grob6000/NixieQuadClock/board/nixiequadclock_pcb_complete.SLDPRT

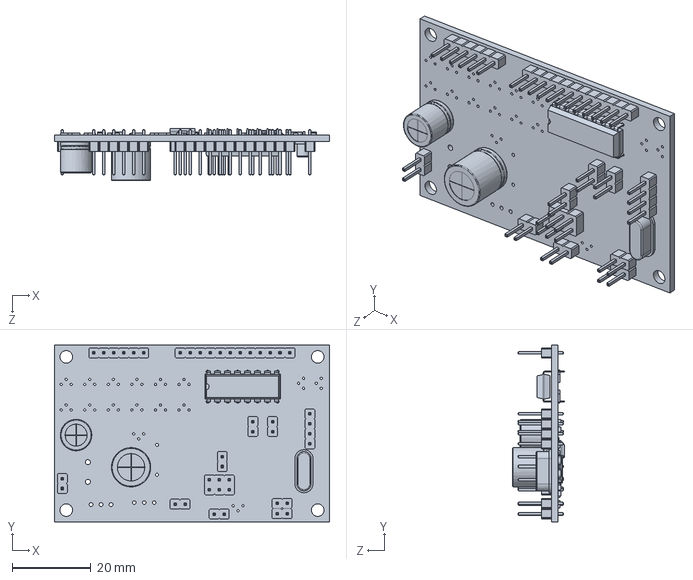
[picture p1: CAD file, 2021-04-23]
board/nixiequadclock_pcb_complete.SLDPRT
70.0 x 45.0 x 13.3 mm
