grob6000/NixieQuadClock/model/nixiequadclock2.SLDASM

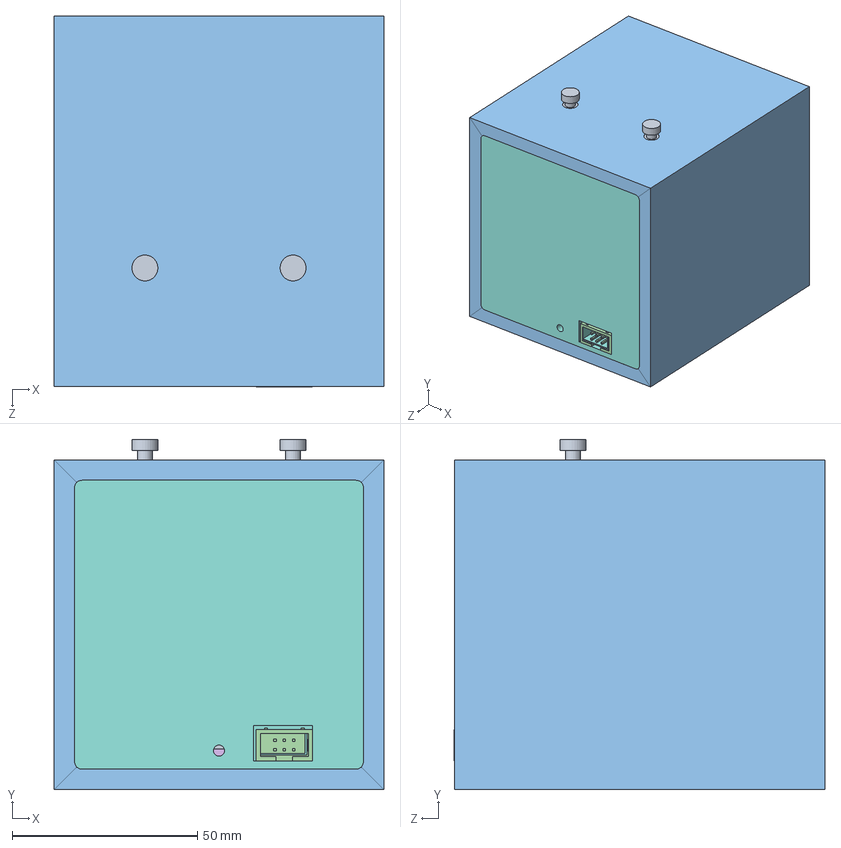
[picture p2: CAD file, 2021-04-23]
model/nixiequadclock2.SLDASM
89.0 x 94.5 x 100.1 mm
nixieblock3
nixie_socket_ukrainian x 4
woodside x 4
in12b x 4
window
gluebracket
circuitboard
plasticback
switch_mini x 2
skm53
skm53_holder
socket_iec6
