grob6000/NixieQuadClock/model/nixiequadclock.SLDASM

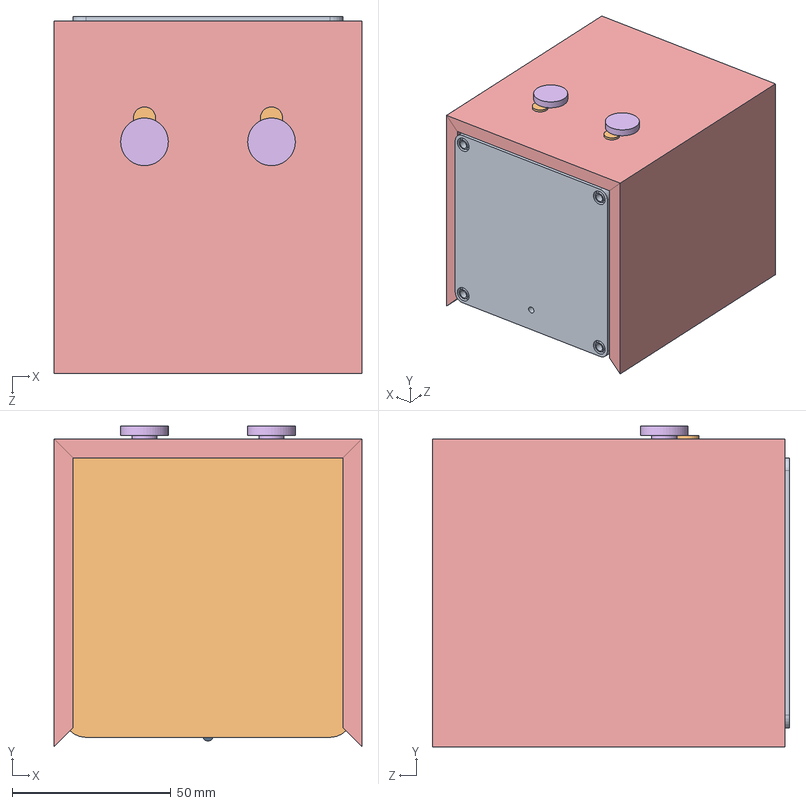
[picture p3: CAD file, 2015-05-10]
model/nixiequadclock.SLDASM
97.0 x 101.0 x 112.5 mm
in12b x 4
window
circuitboard
skm53
woodside x 2
button x 2
nixie_socket_ukrainian x 4
nixieblock_frontblock
nixieblock_rearbox
switch_mini x 2
bolt x 2
nixieblock_wrap
