grob6000/NixieQuadClock/model/woodbox.SLDASM

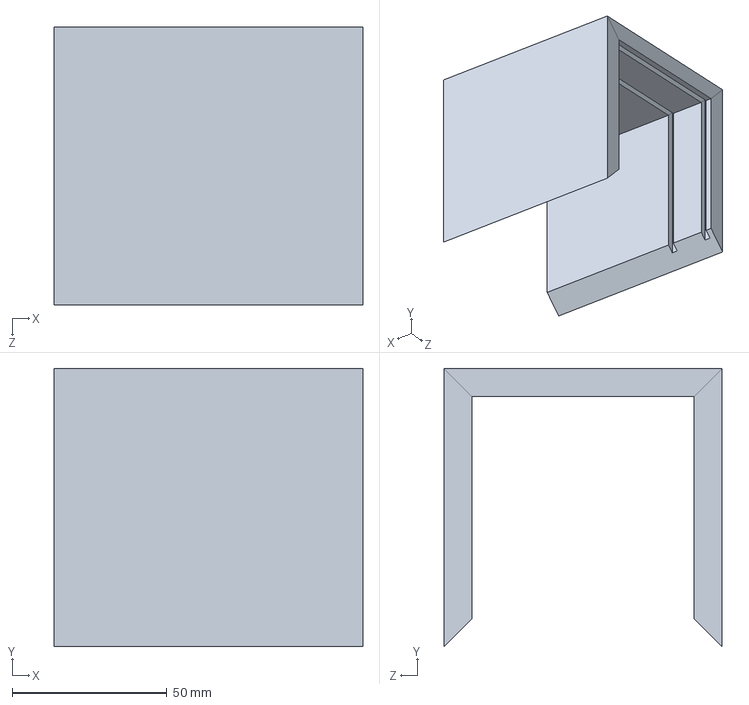
[picture p4: CAD file, 2015-03-24]
model/woodbox.SLDASM
100.0 x 90.0 x 90.0 mm
woodside x 3
