grob6000/NixieQuadClock/model/bell_ebay.step

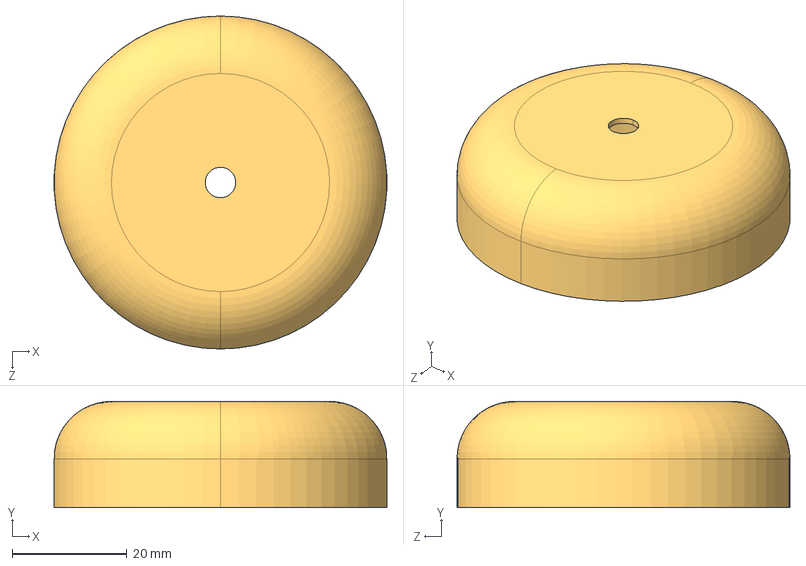
[picture p5: CAD file, 2021-04-23]
model/bell_ebay.step
57.9 x 18.5 x 58.0 mm
