grob6000/NixieQuadClock/board/nixieclockboard.FCStd

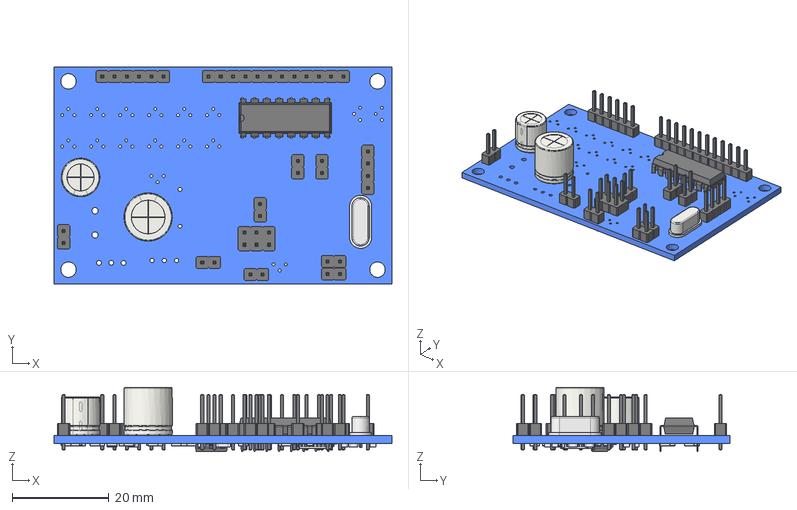
[picture p6: CAD file, 2021-04-23]
board/nixieclockboard.FCStd
70.0 x 45.0 x 13.3 mm
Pcb
C_0805_
C_0805_001
C_0805_002
C_1206_
C_1206_001
C_0805_003
C_0805_004
CP_Radial_D80mm_P380mm_
CP_Radial_D100mm_P500mm_
C_0805_005
C_0805_006
TQFP-32_7x7mm_Pitch0.8mm_
Pin_Header_Straight_1x02_Pitch254mm_
Pin_Header_Straight_1x02_Pitch254mm_001
Pin_Header_Straight_1x02_Pitch254mm_002
Pin_Header_Straight_1x04_Pitch254mm_
Pin_Header_Straight_1x02_Pitch254mm_003
Pin_Header_Straight_1x02_Pitch254mm_004
Pin_Header_Straight_1x12_Pitch254mm_
Pin_Header_Straight_1x06_Pitch254mm_
Pin_Header_Straight_1x02_Pitch254mm_005
Pin_Header_Straight_1x02_Pitch254mm_006
Pin_Header_Straight_1x02_Pitch254mm_007
R_0805_
R_0805_001
R_0805_002
R_0805_003
R_0805_004
R_0805_005
R_0805_006
R_0805_007
R_0805_008
R_0805_009
R_0805_010
R_0805_011
R_0805_012
R_0805_013
R_0805_014
R_0805_015
R_0805_016
R_0805_017
R_0805_018
R_0805_019
R_0805_020
R_0805_021
R_0805_022
R_0805_023
R_0805_024
R_0805_025
R_0805_026
R_0805_027
R_0805_028
R_0805_029
R_0805_030
R_0805_031
R_0805_032
R_0805_033
R_0805_034
R_0805_035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
