grob6000/NixieQuadClock/model/in12b.step

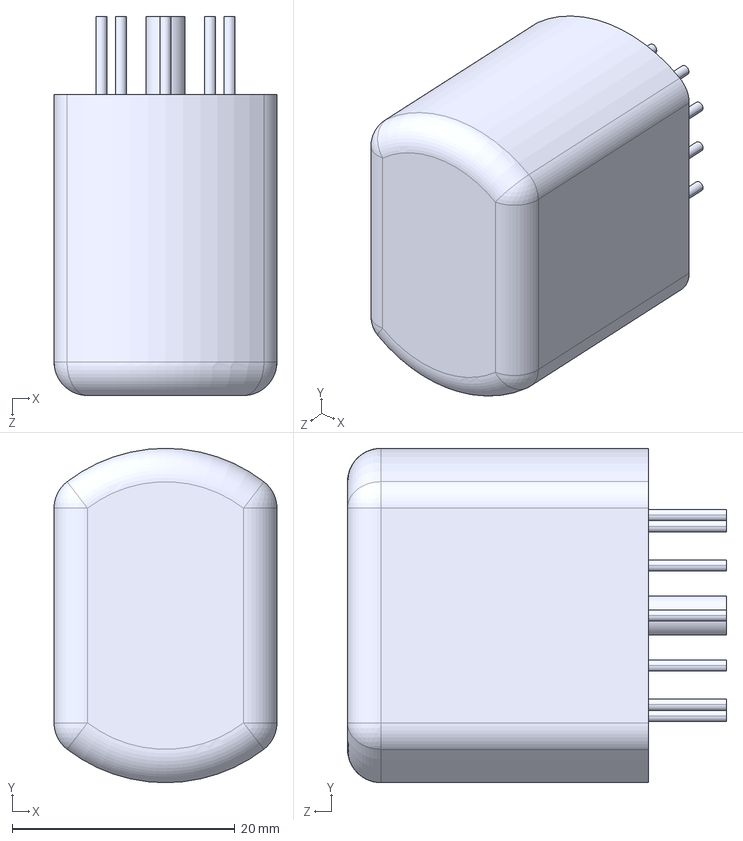
[picture p7: CAD file, 2021-04-23]
model/in12b.step
20.0 x 30.0 x 34.0 mm
