grob6000/NixieQuadClock/model/nixieblock_rearbox.step

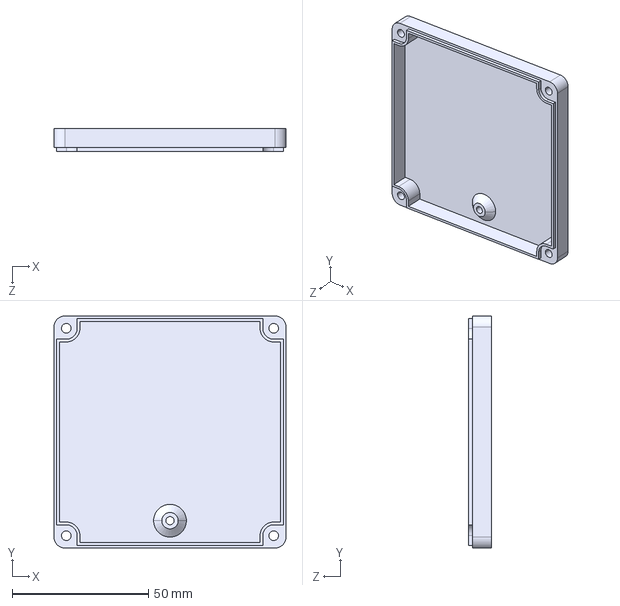
[picture p8: CAD file, 2021-04-23]
model/nixieblock_rearbox.step
85.0 x 85.0 x 8.50 mm
