grob6000/NixieQuadClock/model/nixieblock_frontblock.step

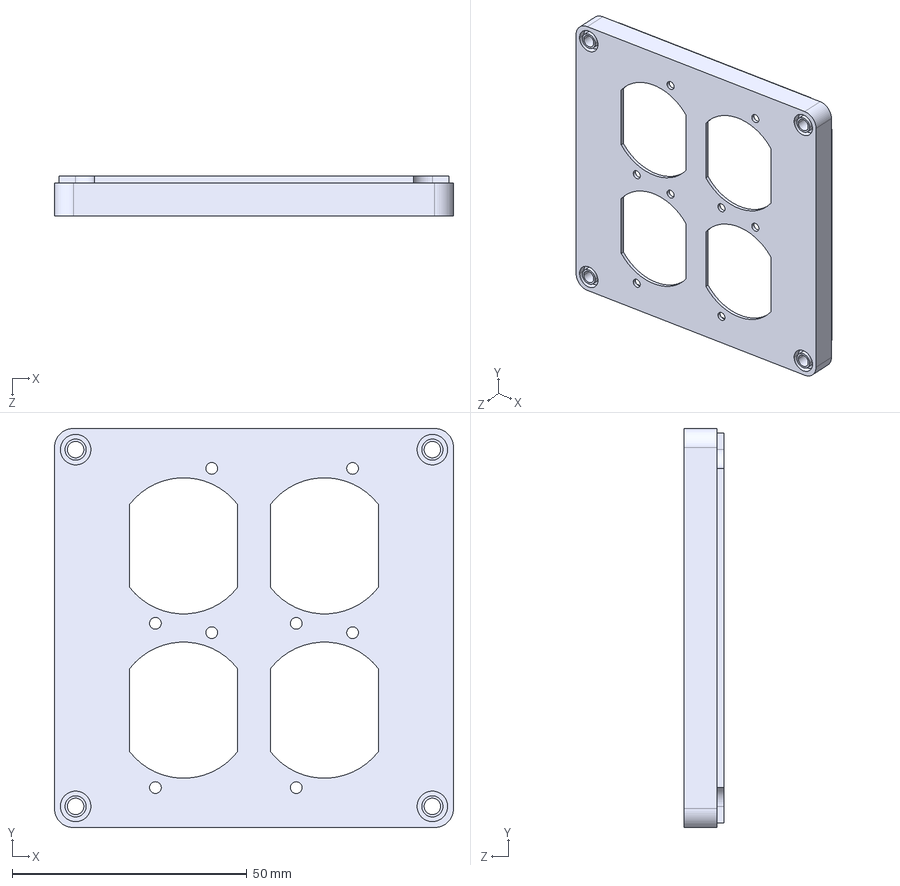
[picture p9: CAD file, 2021-04-23]
model/nixieblock_frontblock.step
85.0 x 85.0 x 8.50 mm
