grob6000/NixieQuadClock/model/sphereclock.step

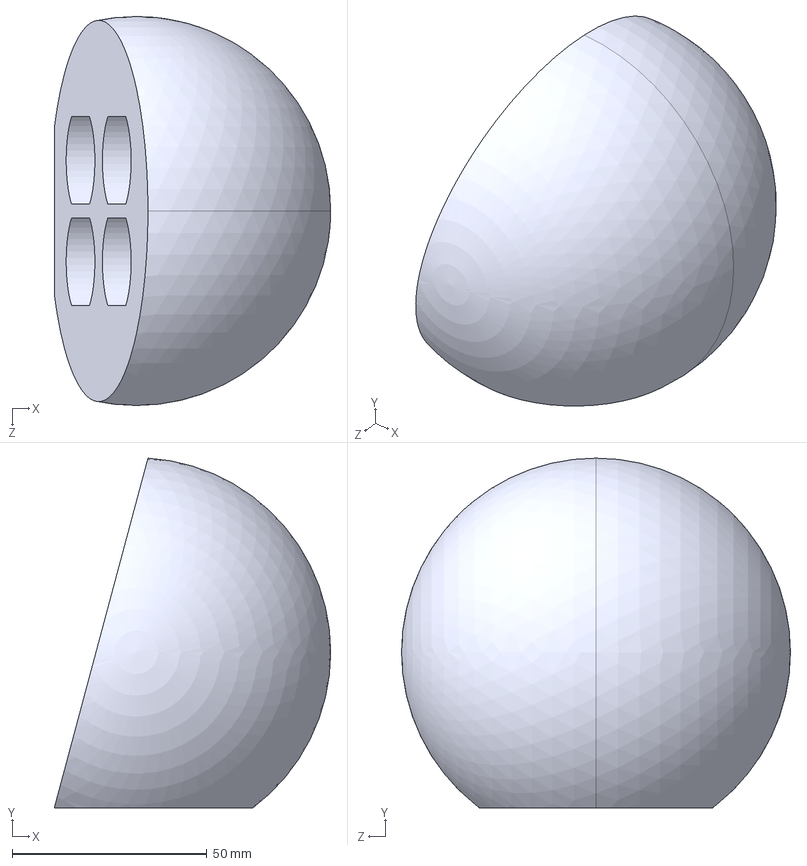
[picture p10: CAD file, 2021-04-23]
model/sphereclock.step
71.1 x 89.9 x 100.0 mm
