grob6000/NixieQuadClock/model/nixieblock.step

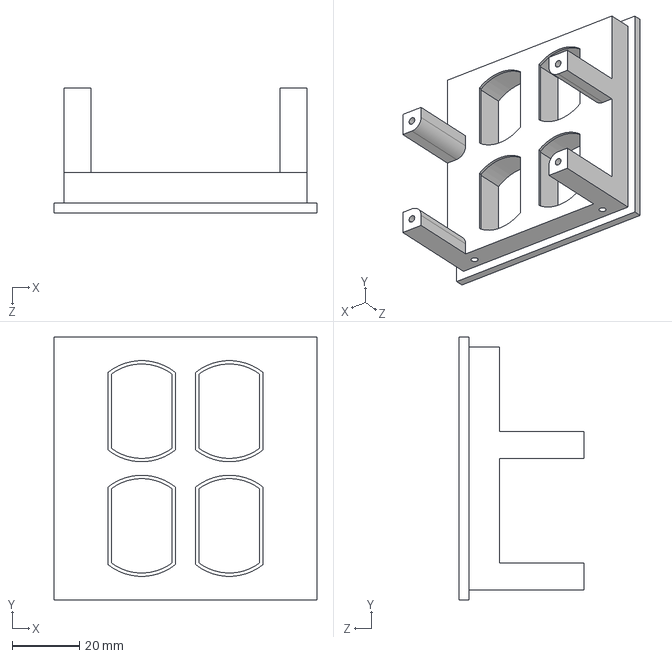
[picture p11: CAD file, 2021-04-23]
model/nixieblock.step
78.0 x 78.0 x 37.0 mm
