grob6000/NixieQuadClock/model/isolationboard.step

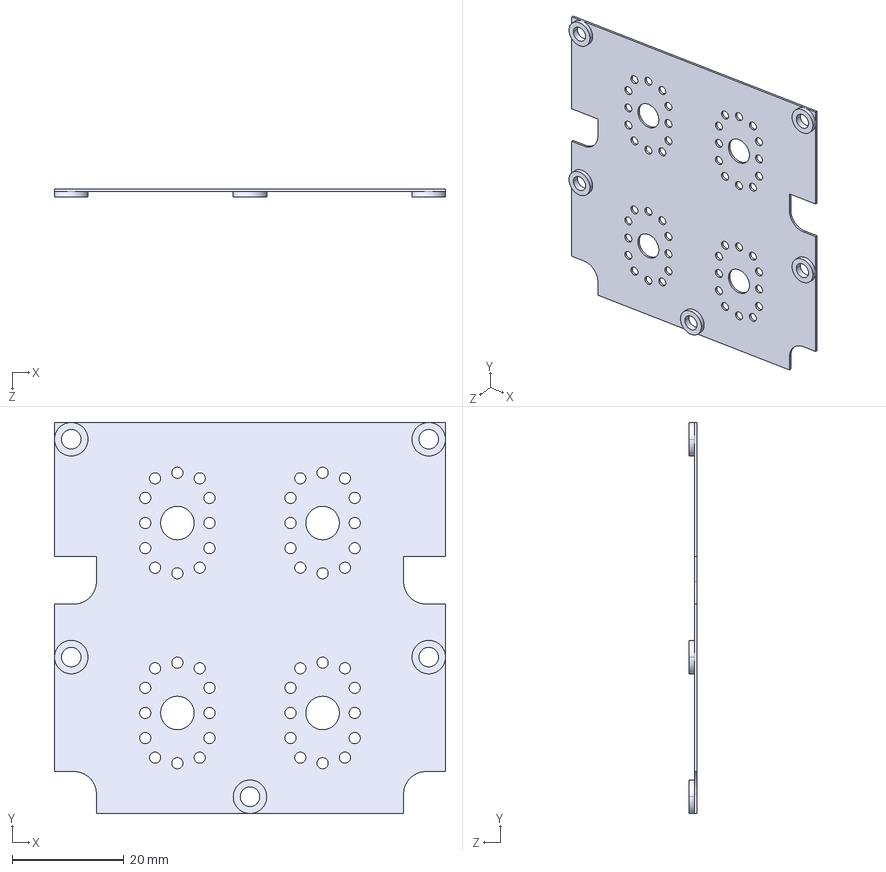
[picture p12: CAD file, 2021-04-23]
model/isolationboard.step
70.0 x 70.0 x 1.50 mm
