grob6000/NixieQuadClock/model/frontflat.step

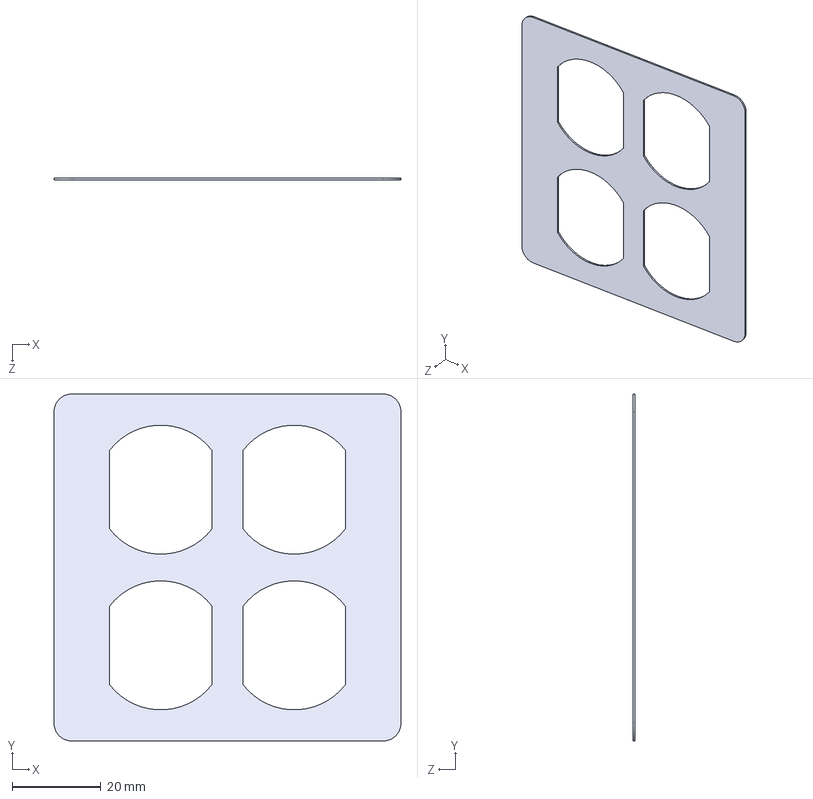
[picture p13: CAD file, 2021-04-23]
model/frontflat.step
78.0 x 78.0 x 0.5 mm
