grob6000/NixieQuadClock/model/skm53_holder.step

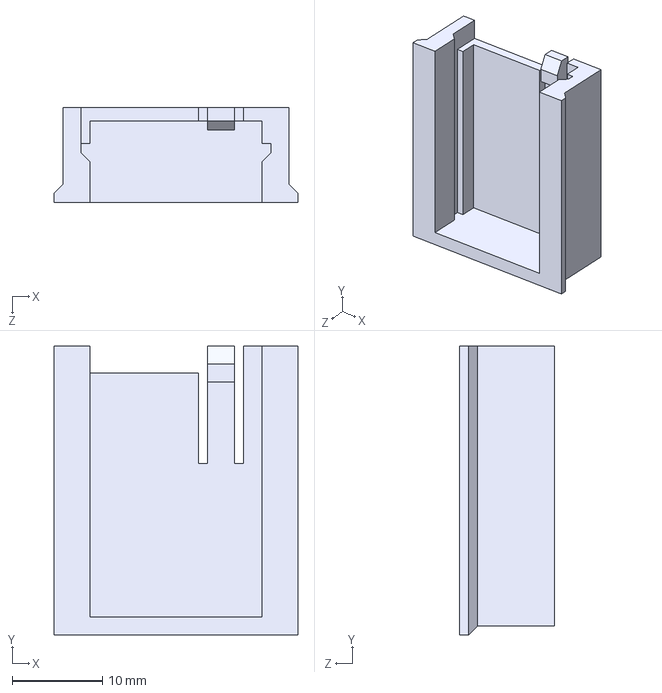
[picture p14: CAD file, 2021-04-23]
model/skm53_holder.step
27.0 x 32.0 x 10.5 mm
