grob6000/NixieQuadClock/model/gluebracket.step

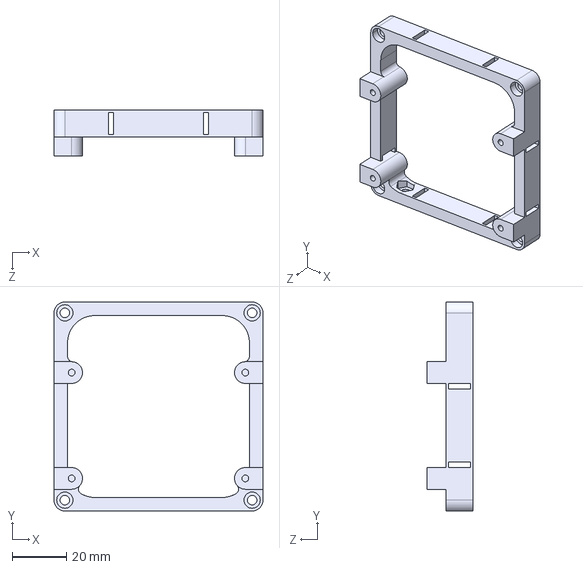
[picture p15: CAD file, 2021-04-23]
model/gluebracket.step
77.0 x 77.0 x 17.0 mm
