grob6000/NixieQuadClock/model/case.step

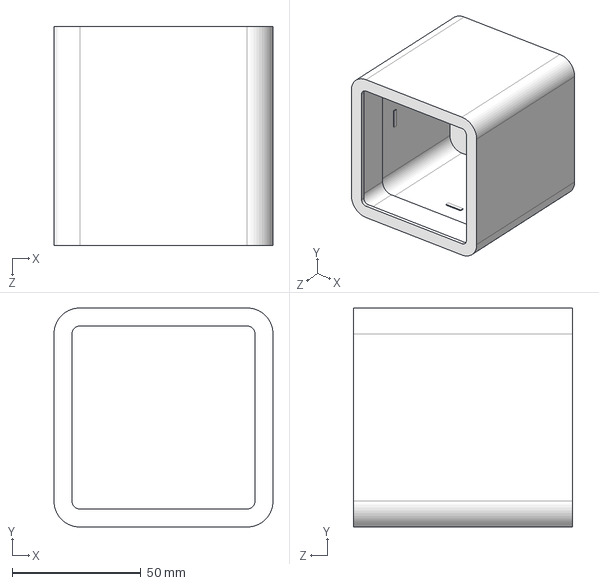
[picture p16: CAD file, 2021-04-23]
model/case.step
85.0 x 85.0 x 85.0 mm
