grob6000/NixieQuadClock/model/nixie_socket_ukrainian.step

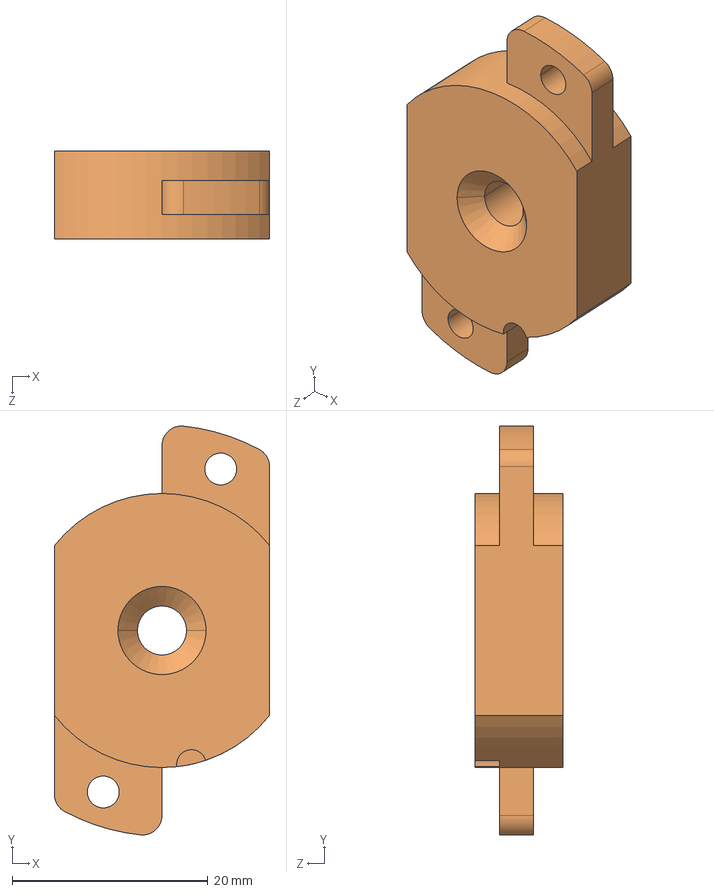
[picture p17: CAD file, 2021-04-23]
model/nixie_socket_ukrainian.step
22.0 x 41.8 x 9.00 mm
