grob6000/NixieQuadClock/model/plasticback.step

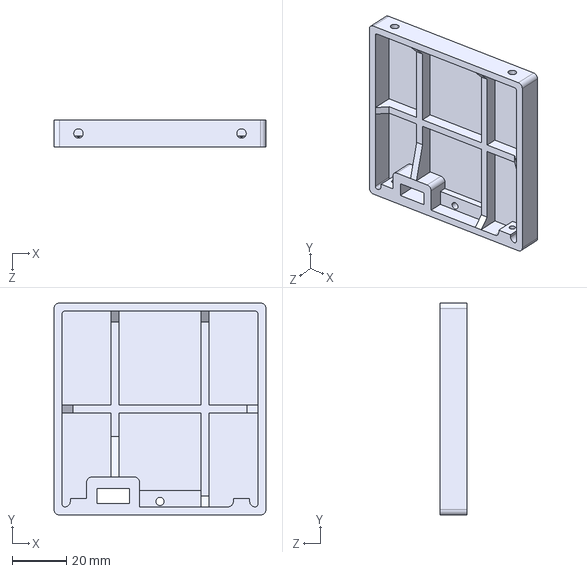
[picture p18: CAD file, 2021-04-23]
model/plasticback.step
78.0 x 78.0 x 10.0 mm
