grob6000/NixieQuadClock/model/window.step

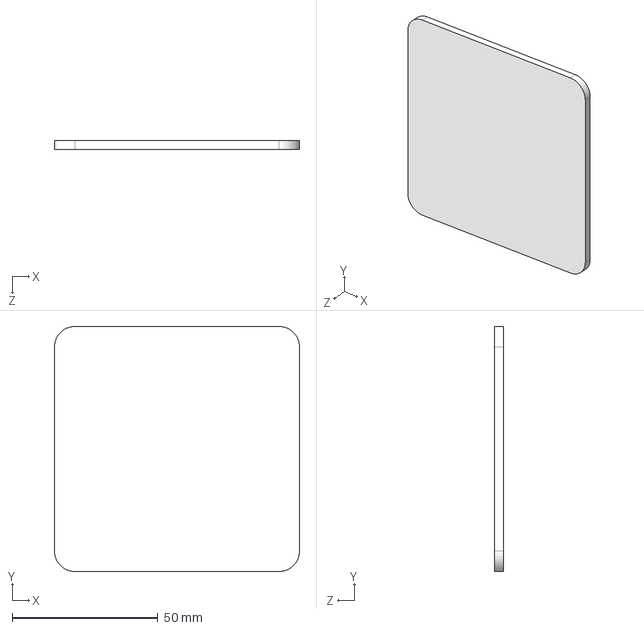
[picture p19: CAD file, 2021-04-23]
model/window.step
84.0 x 84.0 x 3.00 mm
