grob6000/NixieQuadClock/model/nixieblock2.step

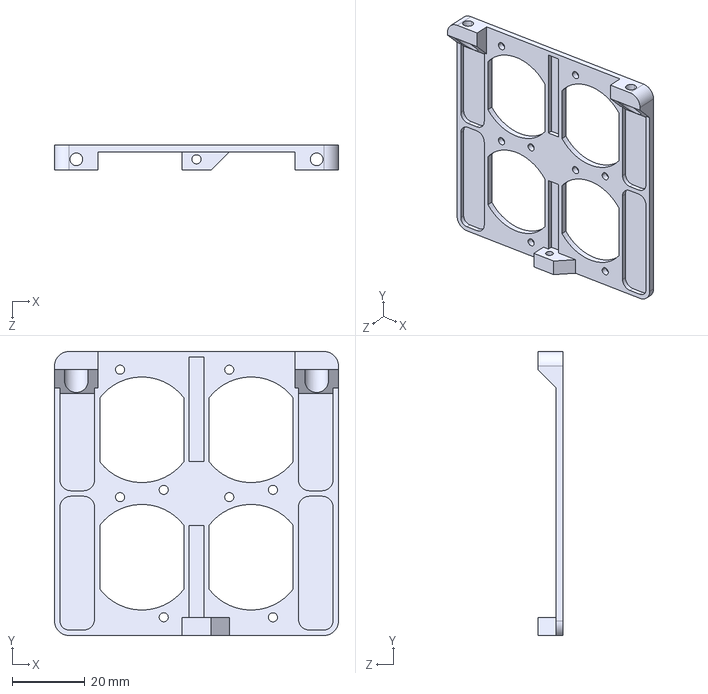
[picture p20: CAD file, 2021-04-23]
model/nixieblock2.step
78.0 x 78.0 x 7.00 mm
