grob6000/NixieQuadClock/model/buttonspring.step

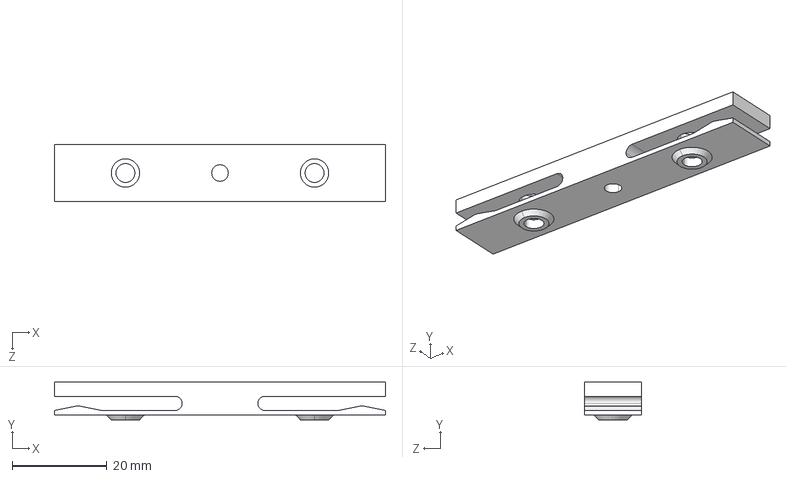
[picture p21: CAD file, 2021-04-23]
model/buttonspring.step
70.0 x 8.00 x 12.0 mm
