grob6000/NixieQuadClock/model/nixieblock_wrap.step

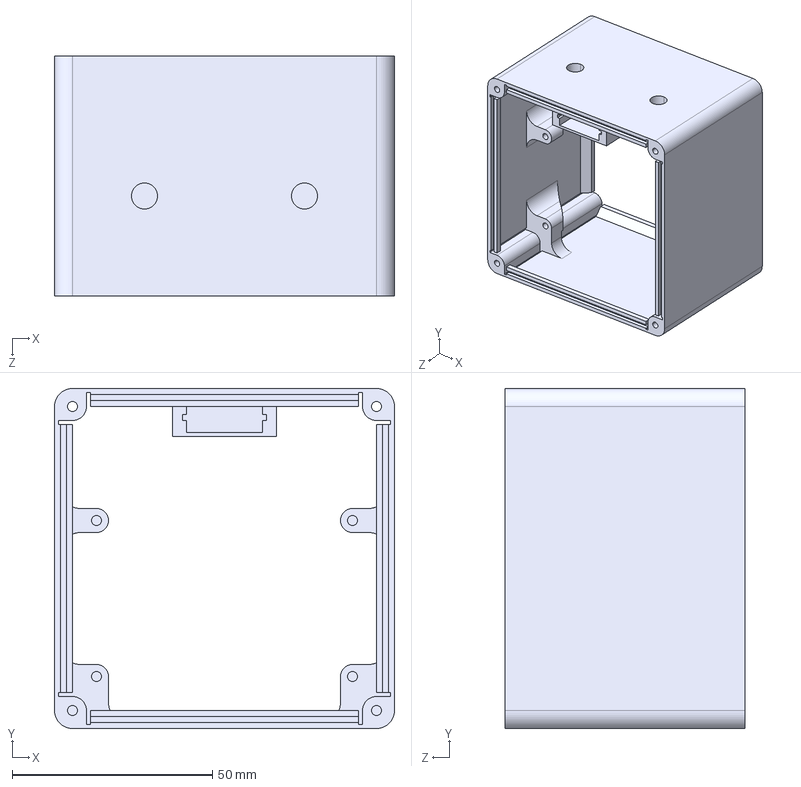
[picture p22: CAD file, 2021-04-23]
model/nixieblock_wrap.step
85.0 x 85.0 x 60.0 mm
