grob6000/NixieQuadClock/model/gpstray.step

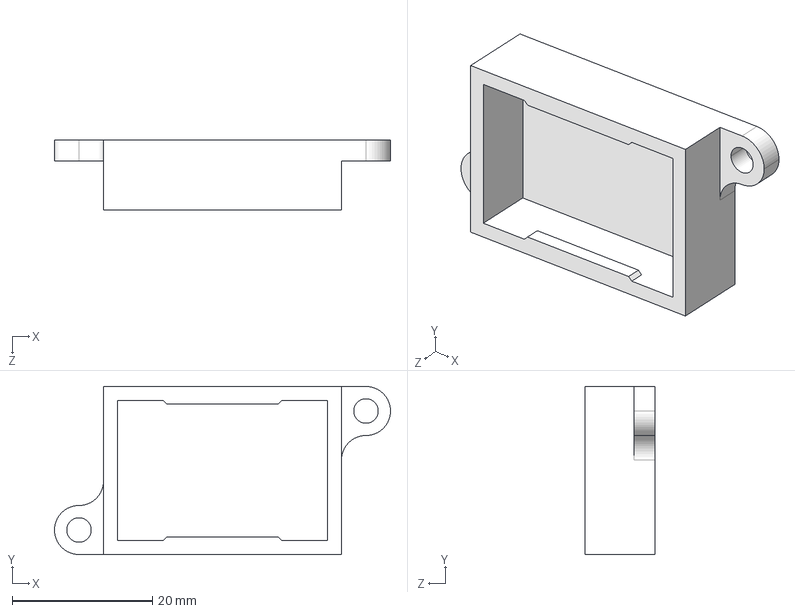
[picture p23: CAD file, 2021-04-23]
model/gpstray.step
48.0 x 24.0 x 10.0 mm
