grob6000/NixieQuadClock/model/woodside.step

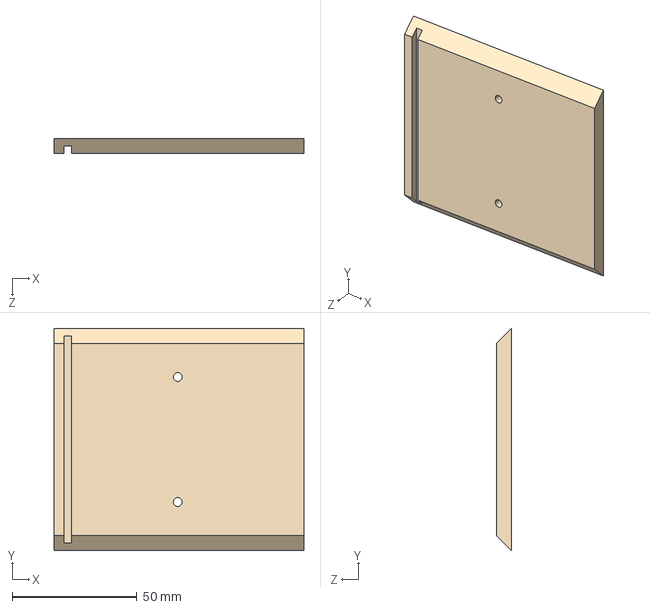
[picture p24: CAD file, 2021-04-23]
model/woodside.step
100.0 x 89.0 x 6.00 mm
