grob6000/NixieQuadClock/model/endformer.step

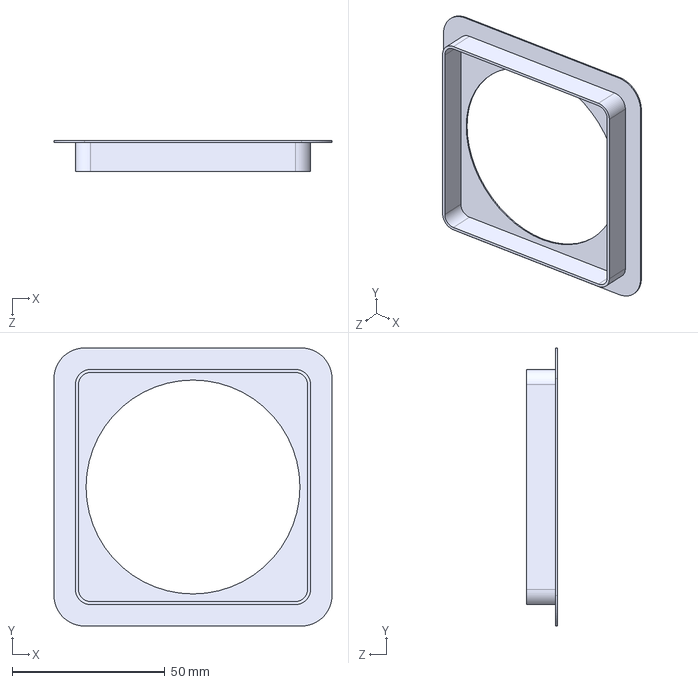
[picture p25: CAD file, 2021-04-23]
model/endformer.step
91.0 x 91.0 x 10.0 mm
