grob6000/NixieQuadClock/model/nixieblock3.step

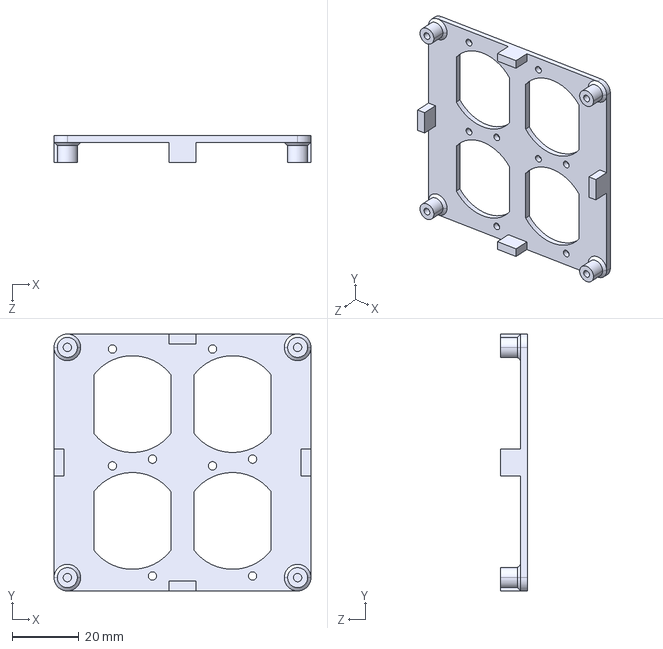
[picture p26: CAD file, 2021-04-23]
model/nixieblock3.step
77.0 x 77.0 x 8.00 mm
