grob6000/NixieQuadClock/model/socket_iec6.step

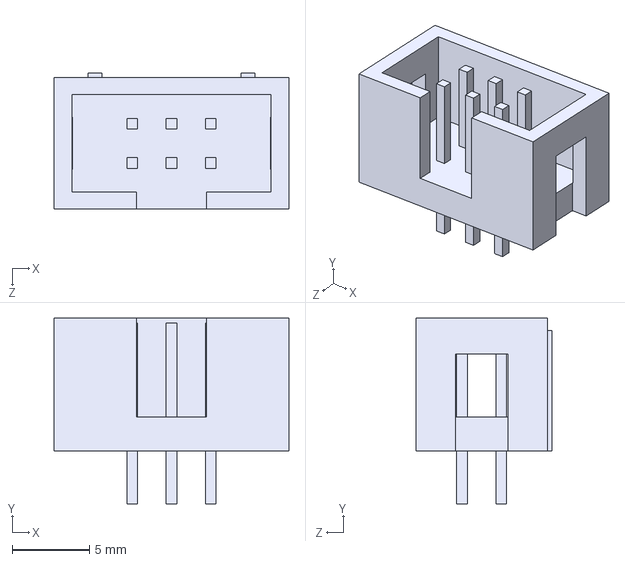
[picture p27: CAD file, 2021-04-23]
model/socket_iec6.step
15.2 x 12.0 x 8.80 mm
