grob6000/NixieQuadClock/model/skm53.step

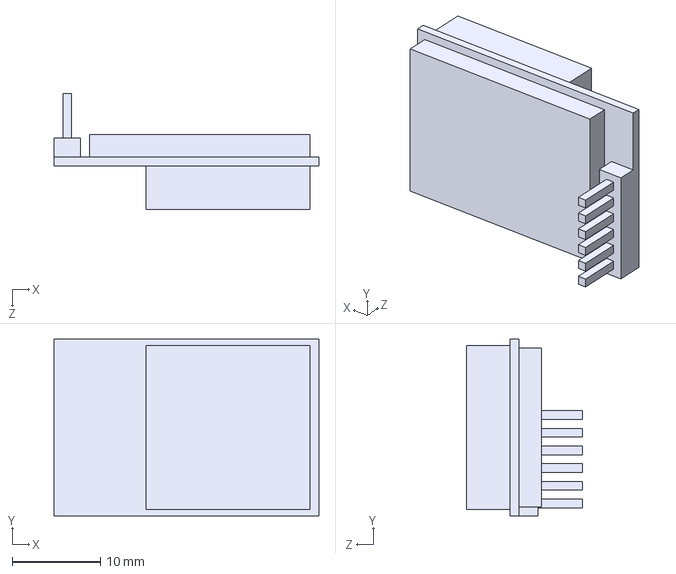
[picture p28: CAD file, 2021-04-23]
model/skm53.step
30.0 x 20.0 x 13.1 mm
