grob6000/NixieQuadClock/model/secondarytubeplate.step

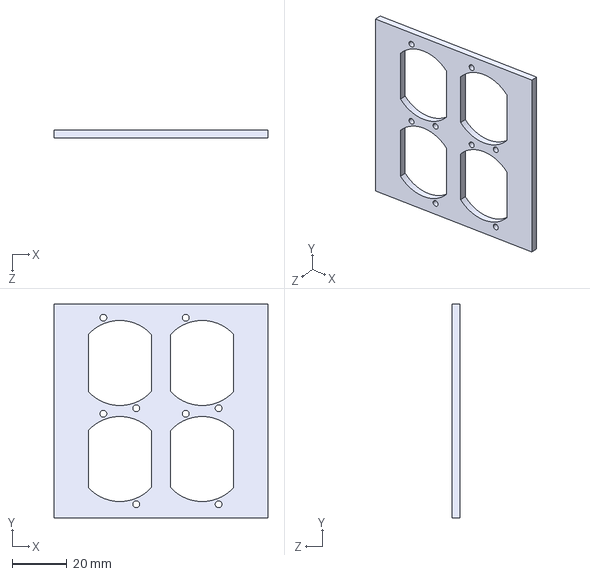
[picture p29: CAD file, 2021-04-23]
model/secondarytubeplate.step
78.0 x 78.0 x 3.00 mm
