grob6000/NixieQuadClock/model/nixieblock_sockets.step

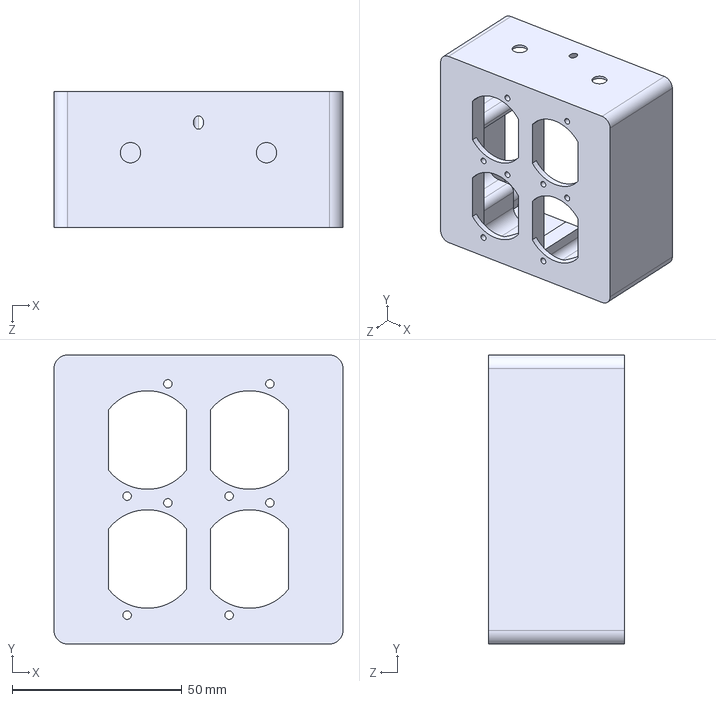
[picture p30: CAD file, 2021-04-23]
model/nixieblock_sockets.step
85.0 x 85.0 x 40.0 mm
