grob6000/NixieQuadClock/model/sphereclock_front.step

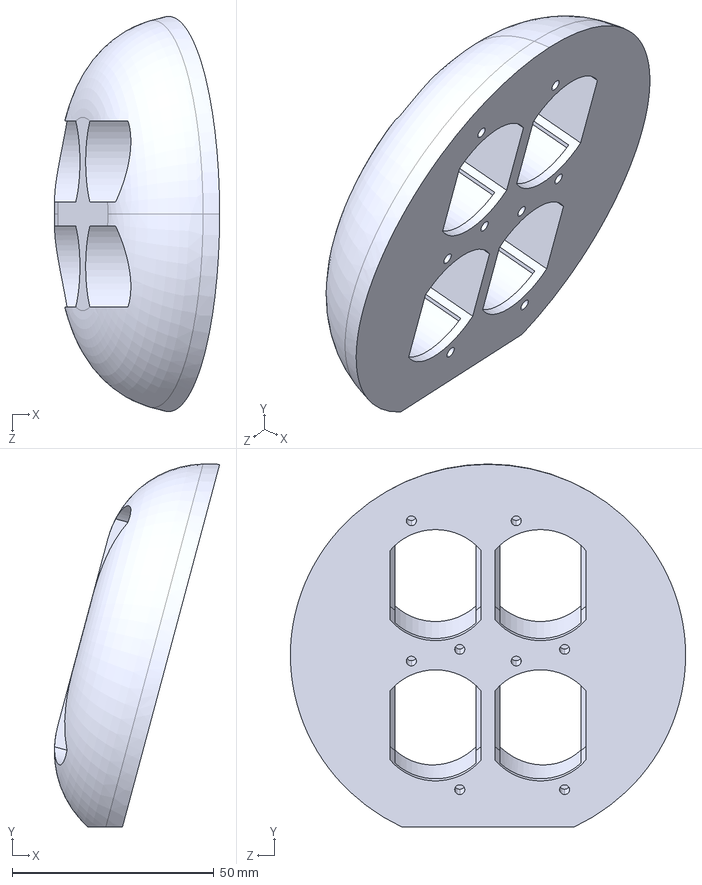
[picture p31: CAD file, 2021-04-23]
model/sphereclock_front.step
41.0 x 90.0 x 98.0 mm
