grob6000/NixieQuadClock/model/circuitboard.step

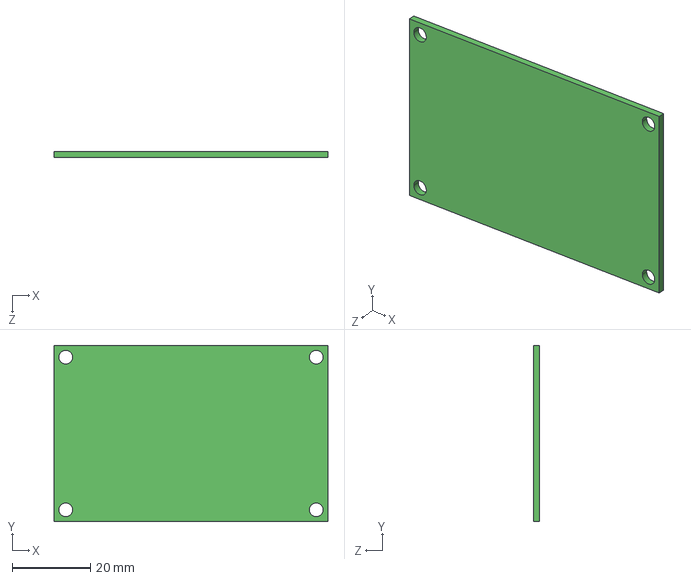
[picture p32: CAD file, 2021-04-23]
model/circuitboard.step
70.0 x 45.0 x 1.60 mm
