grob6000/NixieQuadClock/model/woodback.step

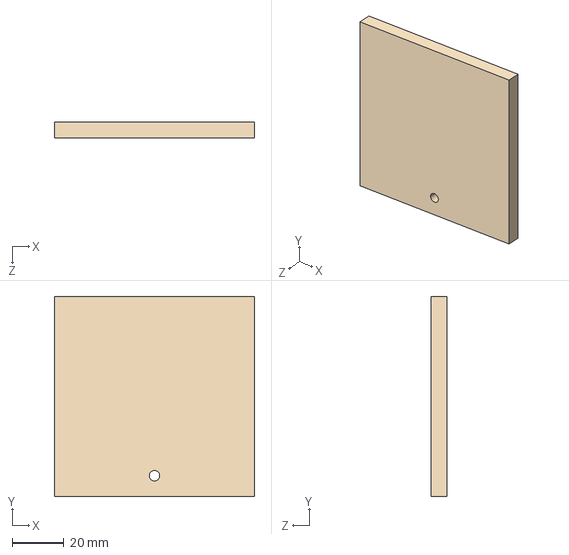
[picture p33: CAD file, 2021-04-23]
model/woodback.step
77.0 x 77.0 x 6.00 mm
