grob6000/NixieQuadClock/model/button.step

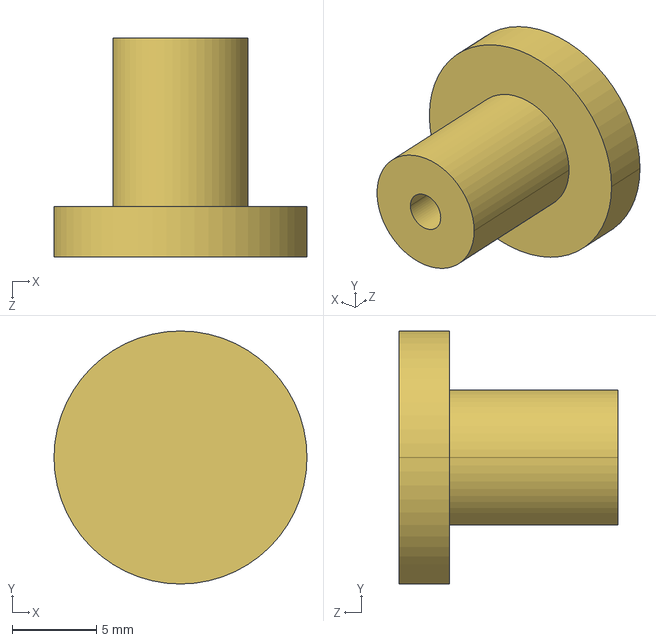
[picture p34: CAD file, 2021-04-23]
model/button.step
15.0 x 15.0 x 13.0 mm
