grob6000/NixieQuadClock/(list of files, cad)

Other CAD files:
model/bell_ebay.SLDPRT
model/bolt.SLDPRT
model/bolt.step
model/button.SLDPRT
model/buttonspring.SLDPRT
model/case.SLDPRT
model/circuitboard.SLDPRT
model/endformer.SLDPRT
model/frontflat.sldprt
model/gluebracket.SLDPRT
model/gpstray.SLDPRT
model/in12b.SLDPRT
model/isolationboard.SLDPRT
model/nixie_socket_ukrainian.SLDPRT
model/nixieblock.SLDPRT
model/nixieblock2.SLDPRT
model/nixieblock3.SLDPRT
model/nixieblock_frontblock.SLDPRT
model/nixieblock_rearbox.SLDPRT
model/nixieblock_sockets.SLDPRT
model/nixieblock_wrap.SLDPRT
model/plasticback.SLDPRT
model/secondarytubeplate.SLDPRT
model/skm53.SLDPRT
model/skm53_holder.SLDPRT
model/socket_iec6.SLDPRT
model/sphereclock.SLDASM
model/sphereclock.SLDPRT
model/sphereclock_front.sldprt
model/switch_mini.SLDPRT
model/window.SLDPRT
model/woodback.SLDPRT
model/woodside.SLDPRT
