grob6000/NixieQuadClock/nixiequadclock_testing.xlsx

Digit | Hex | Display | 1 | 2 | 3 | 4 | 5 | 6 | 7 | 8 | 9 | 10 | 11 | 12 | 13 | 14 | 15 | 16 | Should Display
 |  |  | Out8 (Z) | Out9 | A | D | VCC | B | C | Out2 | Out3 | Out7 | Out6 | GND | Out4 | Out5 | Out1 | Out0
0 | 0x40 | 0 | 31.3 | 73.1 | 0 | 0 | 4.8 | 0 | 0 | 73.1 | 54.7 | 74 | 73.1 | 0 | 73.8 | 74 | 37 | 1 | 0
1 | 0x41 | 8 | 32 | 73.2 | 0 | 4.82 | 4.8 | 0 | 0 | 40.4 | 74.5 | 42.7 | 39.3 | 0 | 73.7 | 58.3 | 23.6 | 72.6 | 8
2 | 0x42 | 4 | 31.4 | 73.2 | 0 | 0 | 4.8 | 0 | 4.8 | 66.4 | 66.5 | 73.6 | 59.7 | 0 | 0 | 73.7 | 33 | 73.9 | 4
3 | 0x43 | 8 | 31.3 | 72.8 | 0 | 4.82 | 4.8 | 0 | 4.81 | 33.3 | 73.6 | 31.6 | 36.8 | 0 | 73.2 | 43.6 | 32.3 | 52.3 | 12
4 | 0x44 | 2 | 30.8 | 53.5 | 0 | 0 | 4.78 | 4.8 | 0 | 0 | 32 | 74.7 | 75.1 | 0 | 71.6 | 74 | 73.4 | 73.2 | 2
5 | 0x45 | 8 | 31.2 | 73.1 | 0 | 4.8 | 4.8 | 48 | 0 | 33.4 | 73.8 | 31.8 | 36.8 | 0 | 73.4 | 43.6 | 52 | 52.1 | 10
6 | 0x46 | 6 | 31.3 | 44.4 | 0 | 0 | 4.8 | 4.8 | 4.8 | 74 | 27.1 | 73.8 | 0 | 0 | 62.5 | 73.6 | 74 | 68.8 | 6
7 | 0x47 | 8 | 31.4 | 72.8 | 0 | 4.8 | 4.8 | 4.8 | 4.8 | 31.6 | 73.2 | 30 | 35.5 | 0 | 73.2 | 41.5 | 52 | 48.4 | 14
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
