grob6000/NixieQuadClock/(threads)

Thread 1 (2015-06-02):

Click changes sound when repeating

grob6000, 2015-06-02:
Suspect timer leak

grob6000, 2015-06-02:
Oops... meant #2

Thread 2 (2015-06-02):

Can't use buttons when alarm is on

grob6000, 2015-06-02:
Time = 22.00
Alarm = 1
TZ = +10.00

grob6000, 2015-06-02:
Fixed 39033b6 - beeper_state during mute was still taking button presses.

grob6000, 2015-06-02:
Requires testing
