grob6000/NixieQuadClock/board/nixieclockboard_schematic_v1.pdf

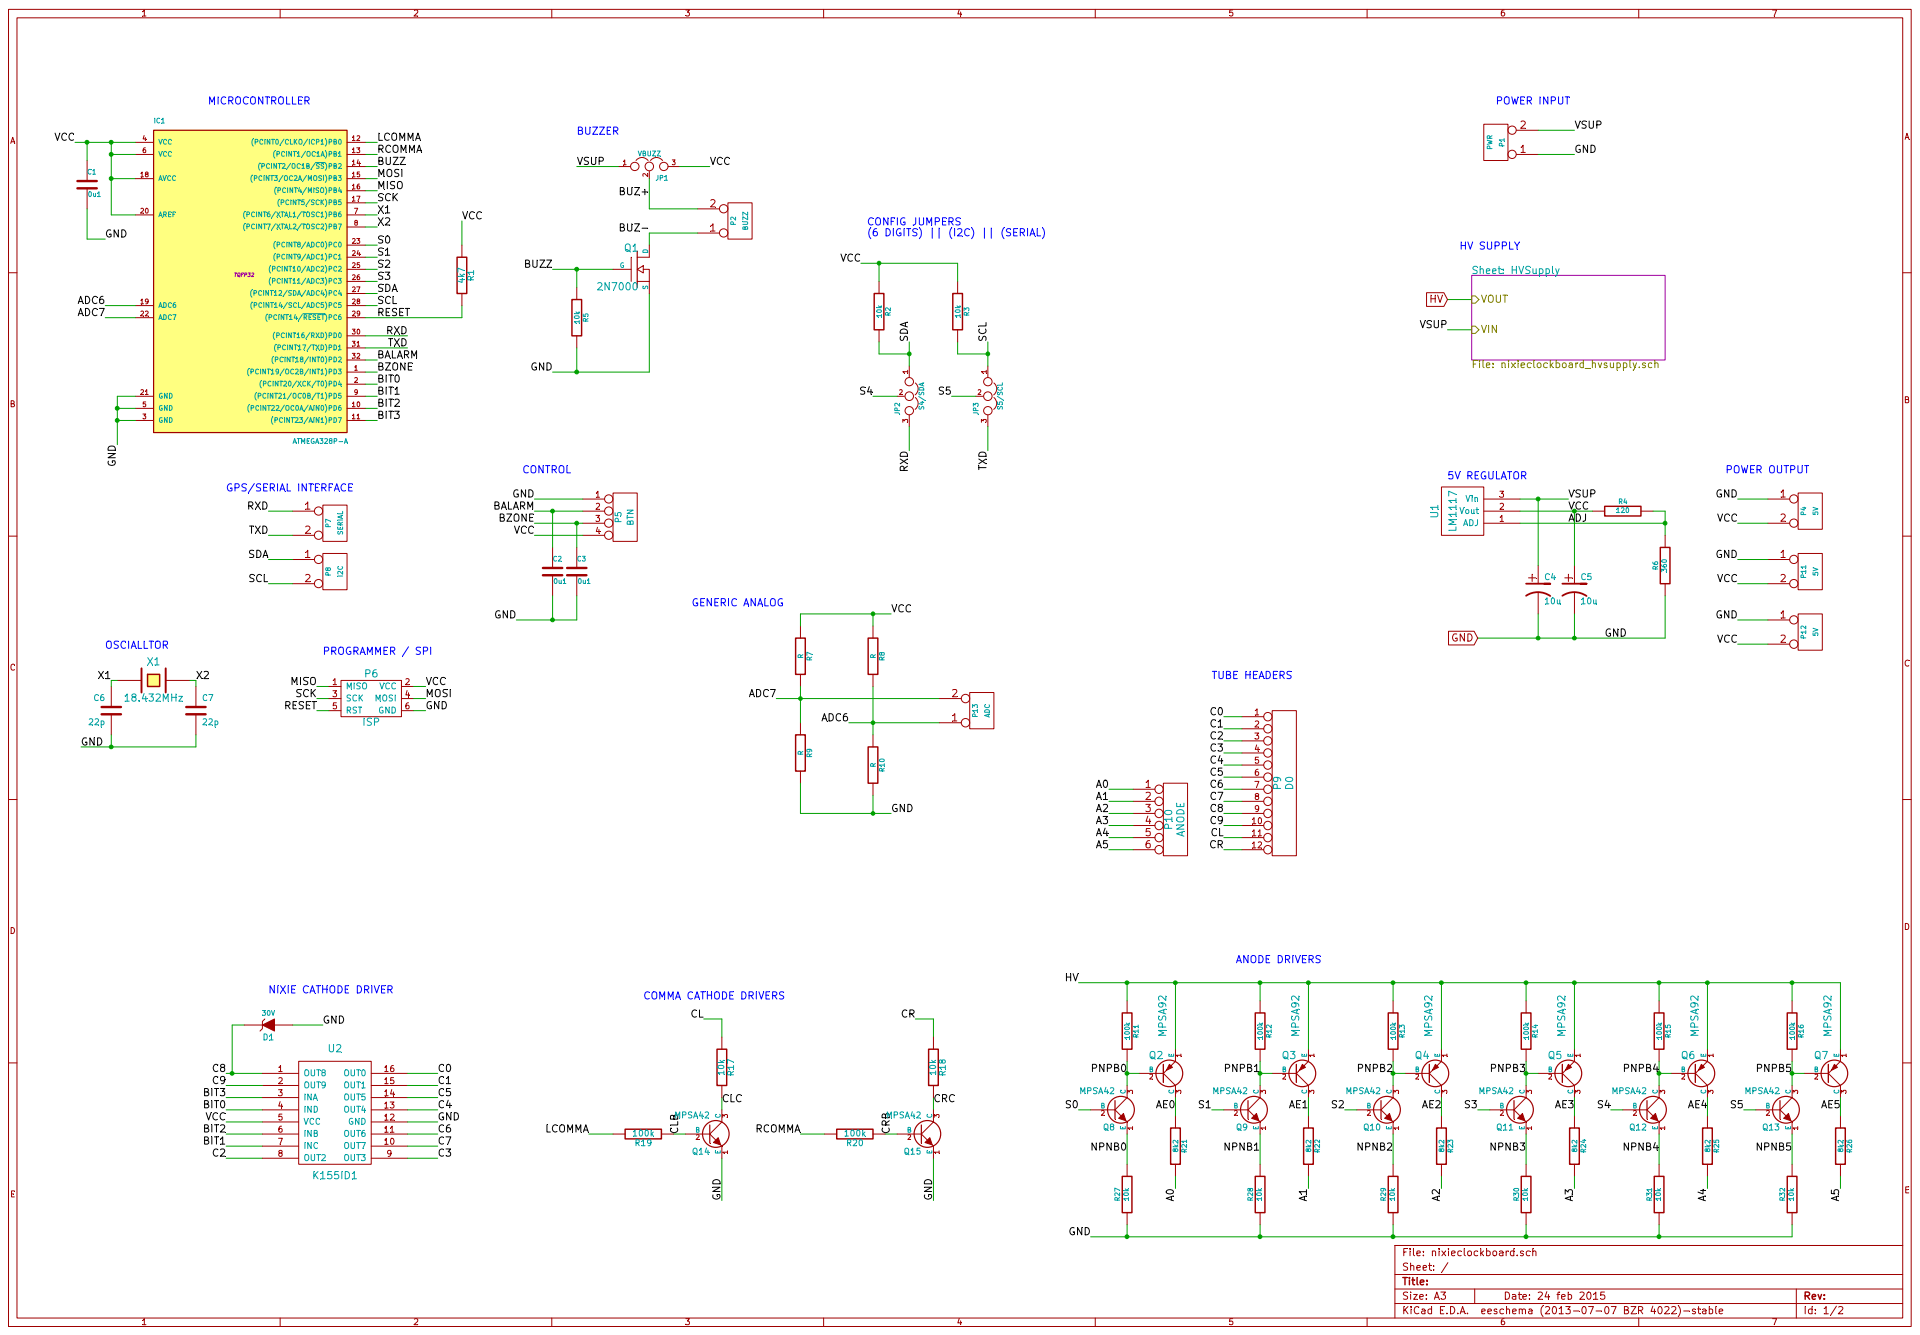
[picture p35: page 1]

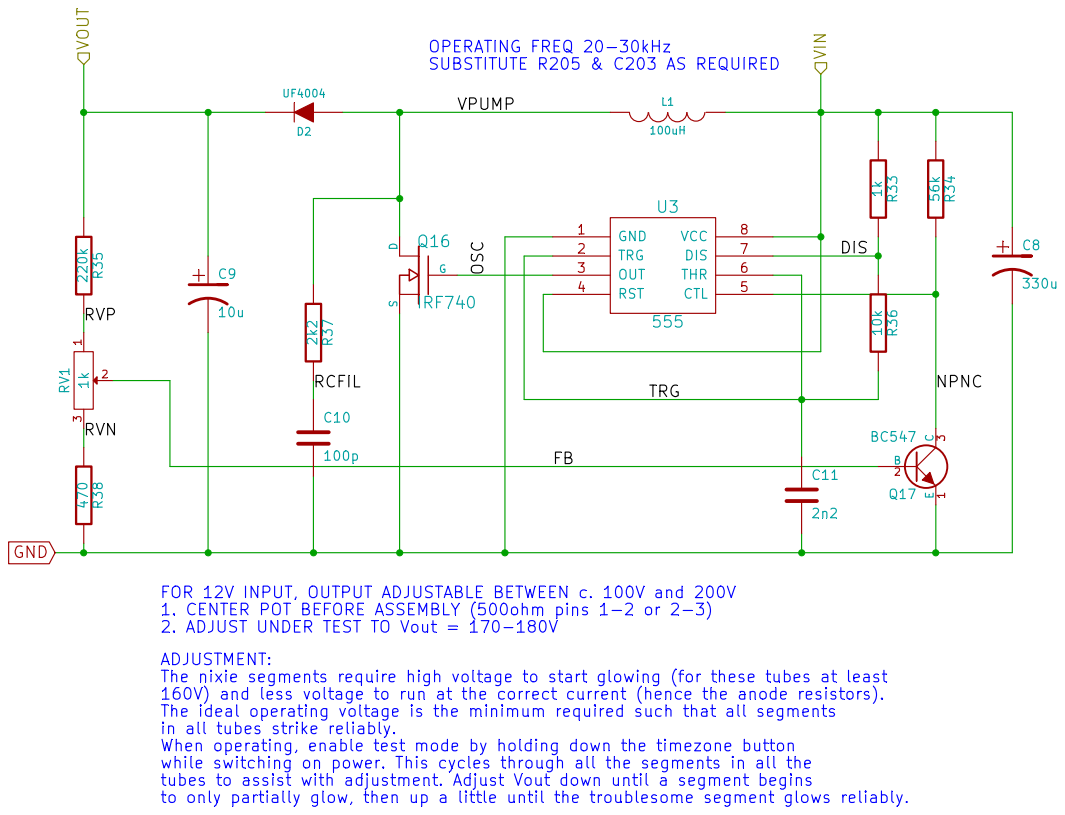
[picture p36: page 2]
