grob6000/NixieQuadClock/board/nixieclockboard.kicad_pcb

## KiCad design board/nixieclockboard.kicad_pcb (2021-04-23)

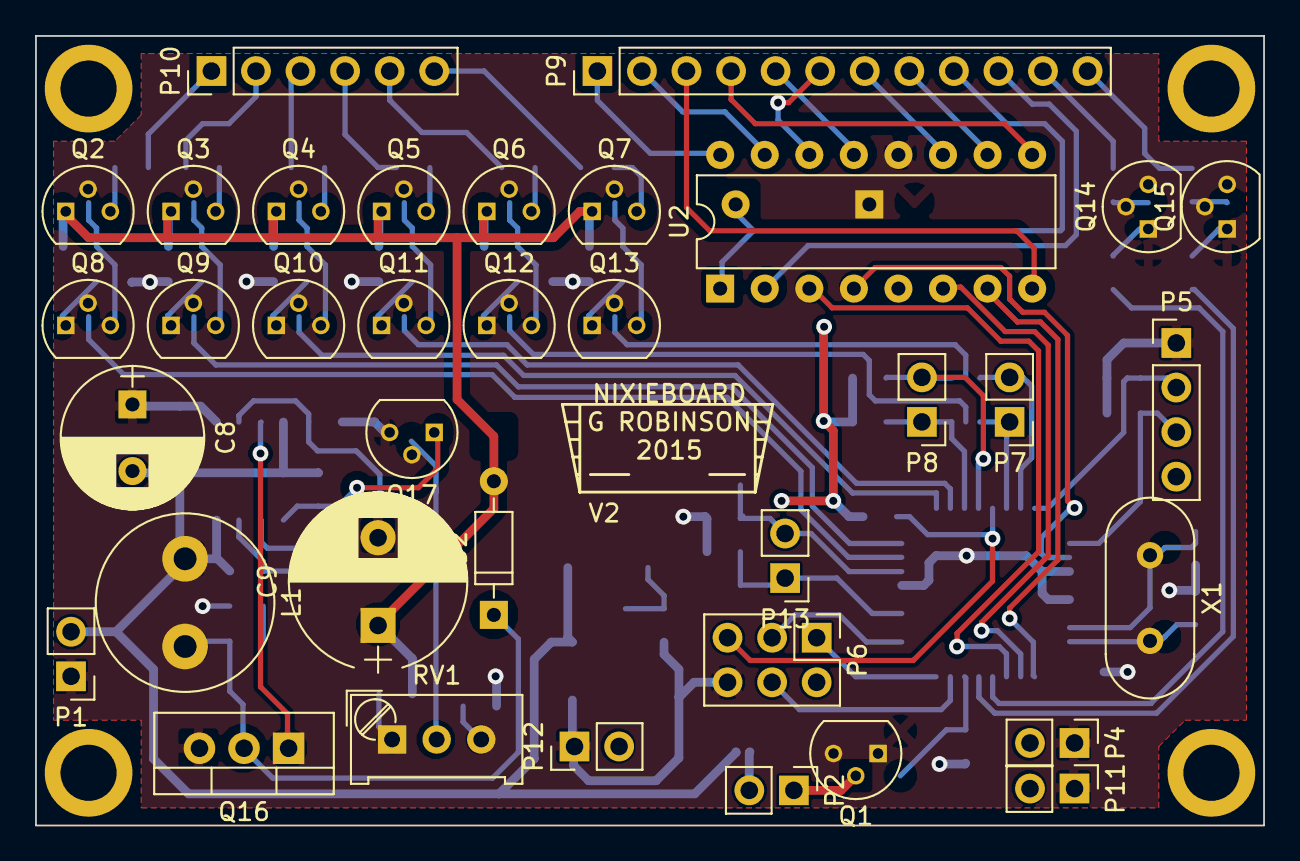
[picture p37: board nixieclockboard.kicad_pcb from above]

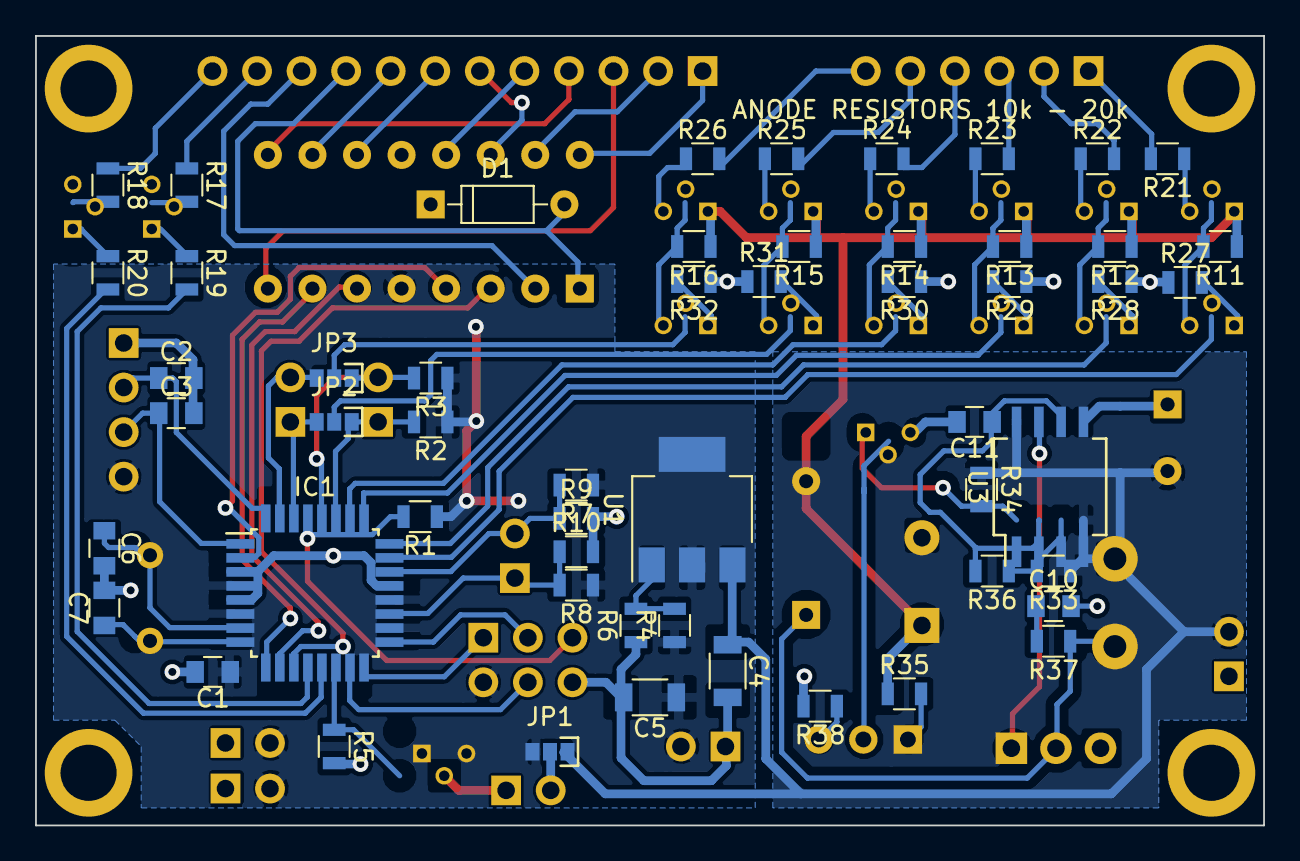
[picture p38: board nixieclockboard.kicad_pcb from below]

Board: 2 copper layers, 70.0 x 45.0 mm, 94 parts (54 on the bottom side), 81 nets.

Parts:
C1, C2, C3: 0u1; C_0805
C4, C5: 10u; C_1206
C6, C7: 22p; C_0805
C8: 330u; CP_Radial_D8.0mm_P3.80mm
C9: 10u; CP_Radial_D10.0mm_P5.00mm
C10: 100p; C_0805
C11: 2n2; C_0805
D1: 30V; D_DO-35_SOD27_P7.62mm_Horizontal
D2: UF4004; D_DO-35_SOD27_P7.62mm_Horizontal
IC1: ATMEGA328P-A; TQFP-32_7x7mm_Pitch0.8mm
JP1: VBUZZ; JUMPER_SMD_3
JP2: S4/SDA; JUMPER_SMD_3
JP3: S5/SCL; JUMPER_SMD_3
L1: 100uH; L_Radial_D10.0mm_P5.00mm_Fastron_07M
P1: PWR; Pin_Header_Straight_1x02_Pitch2.54mm
P2: BUZZ; Pin_Header_Straight_1x02_Pitch2.54mm
P4, P11, P12: 5V; Pin_Header_Straight_1x02_Pitch2.54mm
P5: BTN; Pin_Header_Straight_1x04_Pitch2.54mm
P6: ISP; Pin_Header_Straight_2x03_Pitch2.54mm
P7: SERIAL; Pin_Header_Straight_1x02_Pitch2.54mm
P8: I2C; Pin_Header_Straight_1x02_Pitch2.54mm
P9: D0; Pin_Header_Straight_1x12_Pitch2.54mm
P10: ANODE; Pin_Header_Straight_1x06_Pitch2.54mm
P13: ADC; Pin_Header_Straight_1x02_Pitch2.54mm
Q1: 2N7000; TO-92_Molded_Narrow
Q2, Q3, Q4, Q5, Q6, Q7: MPSA92; TO-92_Molded_Narrow
Q8, Q9, Q10, Q11, Q12, Q13, Q14, Q15: MPSA42; TO-92_Molded_Narrow
Q16: IRF740; TO-220_Vertical
Q17: BC547; TO-92_Molded_Narrow
R1: 4k7; R_0805
R2, R3, R5, R17, R18, R27, R28, R29, R30, R31, R32, R36: 10k; R_0805
R4: 120; R_0805
R6: 360; R_0805
R7, R8, R9, R10, R21, R22, R23, R24, R25, R26: R; R_0805
R11, R12, R13, R14, R15, R16, R19, R20: 100k; R_0805
R33: 1k; R_0805
R34: 56k; R_0805
R35: 220k; R_0805
R37: 2k2; R_0805
R38: 470; R_0805
RV1: 1k; Potentiometer_Trimmer_Bourns_PV36W
SCREW_M3, SCREW_M3#2, SCREW_M3#3, SCREW_M3#4: VAL**; SCREW_M3
U1: LM1117; SOT-223-3Lead_TabPin2
U2: K155ID1; DIP-16_W7.62mm
U3: 555; SO-8_5.3x6.2mm_Pitch1.27mm
X1: 18.432MHz; Crystal_HC49-4H_Vertical

Connections:
/A0: P10.1, R21.2
/A1: P10.2, R22.2
/A2: P10.3, R23.2
/A3: P10.4, R24.2
/A4: P10.5, R25.2
/A5: P10.6, R26.2
/ADC6: IC1.19, P13.1, R8.2, R10.1
/ADC7: IC1.22, P13.2, R7.2, R9.1
/ADJ: R4.2, R6.2, U1.1
/AE0: Q2.3, R21.1
/AE1: Q3.3, R22.1
/AE2: Q4.3, R23.1
/AE3: Q5.3, R24.1
/AE4: Q6.3, R25.1
/AE5: Q7.3, R26.1
/BALARM: C2.1, IC1.32, P5.2
/BIT0: IC1.11, U2.3
/BIT1: IC1.10, U2.6
/BIT2: IC1.9, U2.7
/BIT3: IC1.2, U2.4
/BUZ+: JP1.2, P2.2
/BUZZ: IC1.14, R5.1
/BZONE: C3.1, IC1.1, P5.3
/C0: P9.1, U2.16
/C1: P9.2, U2.15
/C2: P9.3, U2.8
/C3: P9.4, U2.9
/C4: P9.5, U2.13
/C5: P9.6, U2.14
/C6: P9.7, U2.11
/C7: P9.8, U2.10
/C8: D1.2, P9.9, U2.1
/C9: P9.10, U2.2
/CL: P9.11, R17.1
/CLB: Q14.2, R19.1
/CLC: Q14.3, R17.2
/CR: P9.12, R18.1
/CRB: Q15.2, R20.1
/CRC: Q15.3, R18.2
/HVSupply/DIS: R33.2, R36.1, U3.7
/HVSupply/FB: Q17.2, RV1.2
/HVSupply/NPNC: Q17.3, R34.2, U3.5
/HVSupply/RCFIL: C10.1, R37.2
/HVSupply/RVN: R38.1, RV1.3
/HVSupply/RVP: R35.2, RV1.1
/HVSupply/TRG: C11.1, R36.2, U3.2, U3.6
/HVSupply/VPUMP: D2.1, L1.2, R37.1
/LCOMMA: IC1.12, R19.2
/MISO: IC1.16, P6.1
/MOSI: IC1.15, P6.4
/NPNB0: Q8.1, R27.2
/NPNB1: Q9.1, R28.2
/NPNB2: Q10.1, R29.2
/NPNB3: Q11.1, R30.2
/NPNB4: Q12.1, R31.2
/NPNB5: Q13.1, R32.2
/PNPB0: Q2.2, Q8.3, R11.2
/PNPB1: Q3.2, Q9.3, R12.2
/PNPB2: Q4.2, Q10.3, R13.2
/PNPB3: Q5.2, Q11.3, R14.2
/PNPB4: Q6.2, Q12.3, R15.2
/PNPB5: Q7.2, Q13.3, R16.2
/RCOMMA: IC1.13, R20.2
/RESET: IC1.29, P6.5, R1.2
/RXD: IC1.30, JP2.3, P7.1
/S0: IC1.23, Q8.2
/S1: IC1.24, Q9.2
/S2: IC1.25, Q10.2
/S3: IC1.26, Q11.2
/S4: JP2.2, Q12.2
/S5: JP3.2, Q13.2
/SCK: IC1.17, P6.3
/SCL: IC1.28, JP3.1, P8.2, R3.2
/SDA: IC1.27, JP2.1, P8.1, R2.2
/TXD: IC1.31, JP3.3, P7.2
/VCC: C1.1, C5.1, IC1.4, IC1.6, IC1.18, IC1.20, JP1.3, P4.2, P5.4, P6.2, P11.2, P12.2, R1.1, R2.1, R3.1, R4.1, R7.1, R8.1, U1.2, U2.5
/VSUP: C4.1, C8.1, JP1.1, L1.1, P1.2, R33.1, R34.1, U1.3, U3.4, U3.8
/X1: C6.1, IC1.7, X1.1
/X2: C7.1, IC1.8, X1.2
GND: C1.2, C2.2, C3.2, C4.2, C5.2, C6.2, C7.2, C8.2, C9.2, C10.2, C11.2, D1.1, IC1.3, IC1.5, IC1.21, P1.1, P4.1, P5.1, P6.6, P11.1, P12.1, Q14.1, Q15.1, Q17.1, R5.2, R6.1, R9.2, R10.2, R27.1, R28.1, R29.1, R30.1, R31.1, R32.1, R38.2, U2.12, U3.1
HV: C9.1, D2.2, Q2.1, Q3.1, Q4.1, Q5.1, Q6.1, Q7.1, R11.1, R12.1, R13.1, R14.1, R15.1, R16.1, R35.1
