grob6000/NixieQuadClock/(commit log)

2015-01-11 Initial Add Board Files
    [nixieclockboard.sch, nixieclockboard_hvsupply.sch, nixieclockboard_onetube.sch]
2015-01-11 Initial Add Model Files
    [case.SLDPRT, circuitboard.SLDPRT, in12b.SLDPRT, nixieblock.SLDPRT, nixiequadclock.SLDASM, skm53.SLDPRT, window.SLDPRT]
2015-01-11 Schematic updates
    [nixieclockboard.sch, nixieclockboard_hvsupply.sch, nixieclockboard_onetube.sch]
2015-01-21 Schematic and board creation continued
    [nixieclockboard.kicad_pcb, nixieclockboard.sch, nixieclockboard_hvsupply.sch, nixieclockboard_onetube.sch]
2015-03-24 Board completed
    [nixieclockboard.kicad_pcb, nixieclockboard.sch, nixieclockboard_hvsupply.sch]
2015-03-24 Board plot for manufacture
    [nixieclockboard.gbl, nixieclockboard.gbo, nixieclockboard.gbs, nixieclockboard.gtl, nixieclockboard.gto, nixieclockboard.gts]
2015-03-24 Model updates continued
    [bolt.SLDPRT, button.SLDPRT, buttonspring.SLDPRT, circuitboard.SLDPRT, gpstray.SLDPRT, isolationboard.SLDPRT, nixie_socket_ukrainian.SLDPRT, nixieblock.SLDPRT]
2015-05-10 More Board Edits
    [nixieclockboard.sch, nixieclockboard_hvsupply.sch]
2015-05-10 Model Edits
    [frontflat.sldprt, gluebracket.SLDPRT, nixieblock2.SLDPRT, nixieblock3.SLDPRT, nixieblock_frontblock.SLDPRT, nixieblock_rearbox.SLDPRT, nixieblock_sockets.SLDPRT, nixieblock_wrap.SLDPRT]
2015-05-10 Testing spreadsheet
    [nixiequadclock_testing.xlsx]
2015-05-27 Model changes
    [endformer.SLDPRT, gluebracket.SLDPRT, nixieblock3.SLDPRT, nixiequadclock2.SLDASM, plasticback.SLDPRT, woodback.SLDPRT, woodside.SLDPRT]
2015-05-27 Buzzer and alarm implementation
    [nixieclock.c, nixieclock.h]
2015-06-01 Fix eeprom storage bug, fix button repeat delay
    * Used uint8_t where uint16_t was required for temp var
    * Did not set repeat mode correctly in all cases
    [nixieclock.c]
2015-06-02 Replace BUZZER_xx with xx(BUZZ) macros
    For consistency, use of assigned pins.
    [nixieclock.c]
2015-06-02 More sound module
    Still not working!
    [nixieclock.c, nixieclock.h, pins.h, sound.c, sound.h]
2015-06-02 Fix #1 - buttons not working during alarm mute
    [nixieclock.c]
2015-06-02 Fix some defines in nixieclock.h
    [nixieclock.c, nixieclock.h]
2015-06-02 Use pins.h for button checks
2015-06-03 Button check should be low enabled
2015-06-03 Button check should be low enabled 2/2
2015-06-04 Improve pins.h macros
    No longer needs separate definitions for PORTx, DDRx and PINx. Config
    definitions now just letter and bit number.
    [pins.h]
2021-04-23 Add board design
    [nixieclockboard-2019-02-10-10-08-09.sch, nixieclockboard.FCStd, nixieclockboard.kicad_pcb, nixieclockboard.sch, nixieclockboard_hvsupply-2019-02-10-10-08-09.sch, nixieclockboard_hvsupply.sch, nixiequadclock_pcb_complete.SLDPRT]
2021-04-23 SW convert to step files
    [bolt.step, button.step, buttonspring.step, case.step, circuitboard.step, endformer.step, frontflat.step, gluebracket.step]
2021-04-23 Update model
    [bell_ebay.SLDPRT, bell_ebay.step, nixiequadclock2.SLDASM, plasticback.SLDPRT, socket_iec6.SLDPRT]
2021-04-25 Bugfixes in NMEA parsing
    [nixieclock.c]
